Ahmed777-prog/Universal-Sensor2Freq-Optical-Sorting/Hardware Implementation/1.jpeg

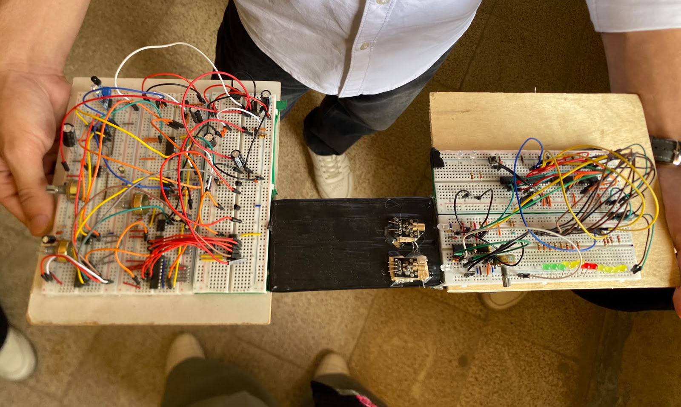
Hardware Implementation/1.jpeg
