Ahmed777-prog/Universal-Sensor2Freq-Optical-Sorting/Documentation/ProjectDocumentation.pdf

# مستند توثيق المشروع )Documentation Project)

اسم المشروع:
Universal Data Acquisition & Optical Sorting Platform )A Frequency-Based Approach for Automated Material Classification( الفريق الهندسي: سعيد حسن، أحمد أكرم، آالء سيد، جنة الجهة األكاديمية: جامعة بنها - كلية الهندسة، قسم هندسة الحاسبات ونظم التحكم

## .1 الملخص التنفيذي )Summary Executive)

يقدم هذا المشروع تصميمًا Platform Automation Customizable). ال | ًا مبتكرًا لمنصة أتمتة شاملة وقابلة للتخصيص )
يقتصر دور النظام على فرز المواد لونيًا Acquisition Data )تعتمد على تحويل | ًا، بل يمتد ليكون منصة عامة الستحواذ البيانات )
المتغيرات الفيزيائية )سواء كانت ضوء، حرارة، أو ضغط( إلى ترددات قابلة للقياس عبر تقنية )Frequency-to-Resistance Conversion). يتم استخالص "بصمة رقمية" )Footprint Digital )دقيقة لهذه الترددات، ومن ثم نقلها السلكي ًا عبر بروتوكول اتصال ضوئي متزامن ومصمم خصيصًا على مستوى العتاد، ليتم استقبالها وفك تشفيرها التخاذ قرار الفرز اآللي. إلثبات نجاح هذه
(، تم تطبيق النظام عملي ًا لفرز المواد بناًء | المعمارية )Concept of Proof على االنعكاس الضوئي.

## .2 بروتوكول االتصال الضوئي المخصص )Optical Custom )Communication Protocol

لضمان نقل البيانات بسرعة وموثوقية عالية في بيئة خالية من المتحكمات الدقيقة )Free-Microcontroller)، تم بناء بروتوكول اتصال صلب )Protocol Level-Hardware )يتميز باآلتي: •نوع االتصال: Simplex متزامن )Synchronous)، ينقل البيانات في اتجاه واحد من مرسل )TX )إلى مستقبل )RX). •القنوات الضوئية المزدوجة )Laser Channel-Dual): يعتمد البروتوكول على وحدتي ليزر منفصلتين؛ قناة مخصصة لنقل البيانات المحملة )LASER_DATA )وقناة مخصصة لنبضات التزامن )LASER_CLK)، مما يضمن دقة النقل ويلغي تعقيدات استرجاع التزامن )Recovery Clock). •تزامن العتاد )Handshaking Hardware): •إدارة اإلرسال )Switch-Kill TX): يتم تجميد النظام تمامًا فور االنتهاء من إرسال اإلطار )-8bit )باستخدام
مفتاح أمان ديجيتال، لمنع تدفق أي بيانات عشوائية.
•حماية االستقبال )Watchdog RX): يعمل المستقبل بنظام التلقيم الذاتي ليتمكن من اكتشاف نهاية اإلطار
بتات، ويقوم بتجهيز نفسه أوتوماتيكي ًا | المكون من 8 الستقبال اإلطار التالي دون فقدان التزامن.

## .3 المعمارية التقنية والتفصيلية للنظام )Architecture System Detailed)

يتكون النظام من خمس وحدات وظيفية متكاملة تعمل في تزامن تام:

الوحدة األولى: التحكم المركزي واكتشاف األحداث )Detection Event & Control Master) •االستشعار المبدئي: يتم استخدام مستشعر أشعة تحت الحمراء )Sensor IR )الكتشاف دخول المادة إلى نطاق القياس.

•توليد نبضة التزامن )Detection Edge): لضمان دقة بدء النظام، تم تصميم دائرة تفاضلية )Differentiator RC) مع ترانزستور )A2222PN )لتوليد نبضة سالبة سريعة جدًا )Spike Negative). تعمل هذه النبضة كـ )Master Reset )لتهيئة النظام وتصفير كافة العدادات في لحظة الصفر.

الوحدة الثانية: المعالجة الشاملة وتوليد التردد )Frequency-to-Sensor Universal) وهي الوحدة التي تمنح النظام صفة الـ "Universal": •المتذبذب )Astable/VCO): باستخدام مؤقت )555NE)، يتم تحويل قيمة المقاومة المتغيرة للمستشعر )LDR للون، أو Thermistor للحرارة، أو FSR للضغط( إلى تردد مستمر يمثل الخاصية الفيزيائية. •بوابة الزمن الدقيقة )Window Time): باستخدام مؤقت )555NE )آخر في وضع )Monostable)، يتم توليد نافذة
زمنية دقيقة جدًا 100 مللي ثانية( فور تلقي إشارة البدء. هذه النافذة تحدد اإلطار المسموح فيه بأخذ العينات الترددية. | ًا )مث ًال

الوحدة الثالثة: التكميم الرقمي )Quantization Digital) •تقاطع اإلشارات: يتم دمج التردد المتولد مع النافذة الزمنية عبر بوابة )08HC74 - AND)، إلنتاج حزمة محددة من النبضات المتزامنة )CLK_BURST). •استخالص البصمة )Footprint Digital): تمر النبضات إلى عدادات متتالية )- Counters Cascade 161HC74). بنهاية النافذة الزمنية، تحتفظ العدادات برقم ثنائي )-8bit )يمثل الهوية الرقمية الدقيقة للمادة.

الوحدة الرابعة: نظام اإلرسال الضوئي )System TX Optical) •تثبيت البيانات )Latching Data): لتفادي مشكلة التذبذب قبل اإلرسال، تم ابتكار دائرة خطف )Spiker RC )تولد نبضة لحظية لتفعيل طرف التحميل غير المتزامن )~PL )في مسجل اإلزاحة )165HC74)، مما يثبت البيانات قبل وصول النبضة األولى للساعة. •تفعيل اإلرسال: يقوم ُمنطاط )74HC74 - Flop-Flip-D )بتوليد إشارة التفعيل لفتح مسار ساعة اإلرسال، ويغلقه فورًا عند إتمام البت الثامن.
•القيادة )Driving Laser): يتم تضخيم اإلشارات الناتجة باستخدام ترانزستورات لقيادة ثنائيات الليزر بأعلى كفاءة.

الوحدة الخامسة: نظام االستقبال والتصنيف )Classification & RX Optical) •الواجهة التناظرية )End-Front Analog): تستقبل الثنائيات الضوئية )Photodiodes )إشارات الليزر وتمررها عبر مكبرات عمليات )Amps-Op 358LM )لتنقيتها وتحويلها إلى نبضات رقمية حادة )DATA_RX و CLK_RX). •تجميع البيانات )Parallel to Serial): يستقبل مسجل اإلزاحة )595HC74 )البيانات المتسلسلة إلعادة تجميعها، وال يتم تفعيل الخرج إال بعد اكتمال اإلطار لضمان استقرار العرض. •تزامن االستقبال )Restoring Sync): يعتمد النظام على عداد )161HC74 )مبرمج بخاصية التحميل المتزامن )~PE )ليقوم بضبط نفسه لـ 1 تلقائي ًا بمجرد استالم النبضة الثامنة، مما يحمي النظام كلي ًا من فقدان التزامن .)Desynchronization(
•التصنيف النهائي )Decoding): يتم أخذ البتات ذات األهمية القصوى )MSBs )وتمريرها لمفكك شفرة )138HC74 Decoder )لتفعيل مؤشر ضوئي )LED )يعبر عن فئة المادة.

## .4 التحديات الهندسية والحلول )& Challenges Engineering )Robustness

تم إجراء هندسة وقائية للنظام لضمان استقراره في البيئات العملية: .1مشكلة تذبذب البيانات )Output Dancing): تم حلها جذري ًا عبر تصميم دائرة )Generator Pulse )تناظرية باستخدام مكثف لتفعيل إشارة الـ Load لكسر من الميكروثانية وتجميد حالة البيانات. .2مشكلة فقدان التزامن في االستقبال )Desync RX): تم حلها باالستغناء عن البوابات المنطقية المعقدة لصالح استغالل خاصية التلقيم الذاتي المتزامن )Reload-Auto )داخل عدادات الـ RX. .3الضوضاء والتيار اللحظي )Current Inrush): تمت إضافة مكثفات تنعيم )Capacitors Decoupling )مباشرة على الدوائر المتكاملة الحساسة المتصاص التغيرات اللحظية في الجهد الناتجة عن تبديل الـ 8 بتات في نفس اللحظة .)Ground Bounce(
