Ahmed777-prog/Universal-Sensor2Freq-Optical-Sorting/Schematics/Frequency-to-Digital Coverter via Li-Fi Latest Schematic.pdf

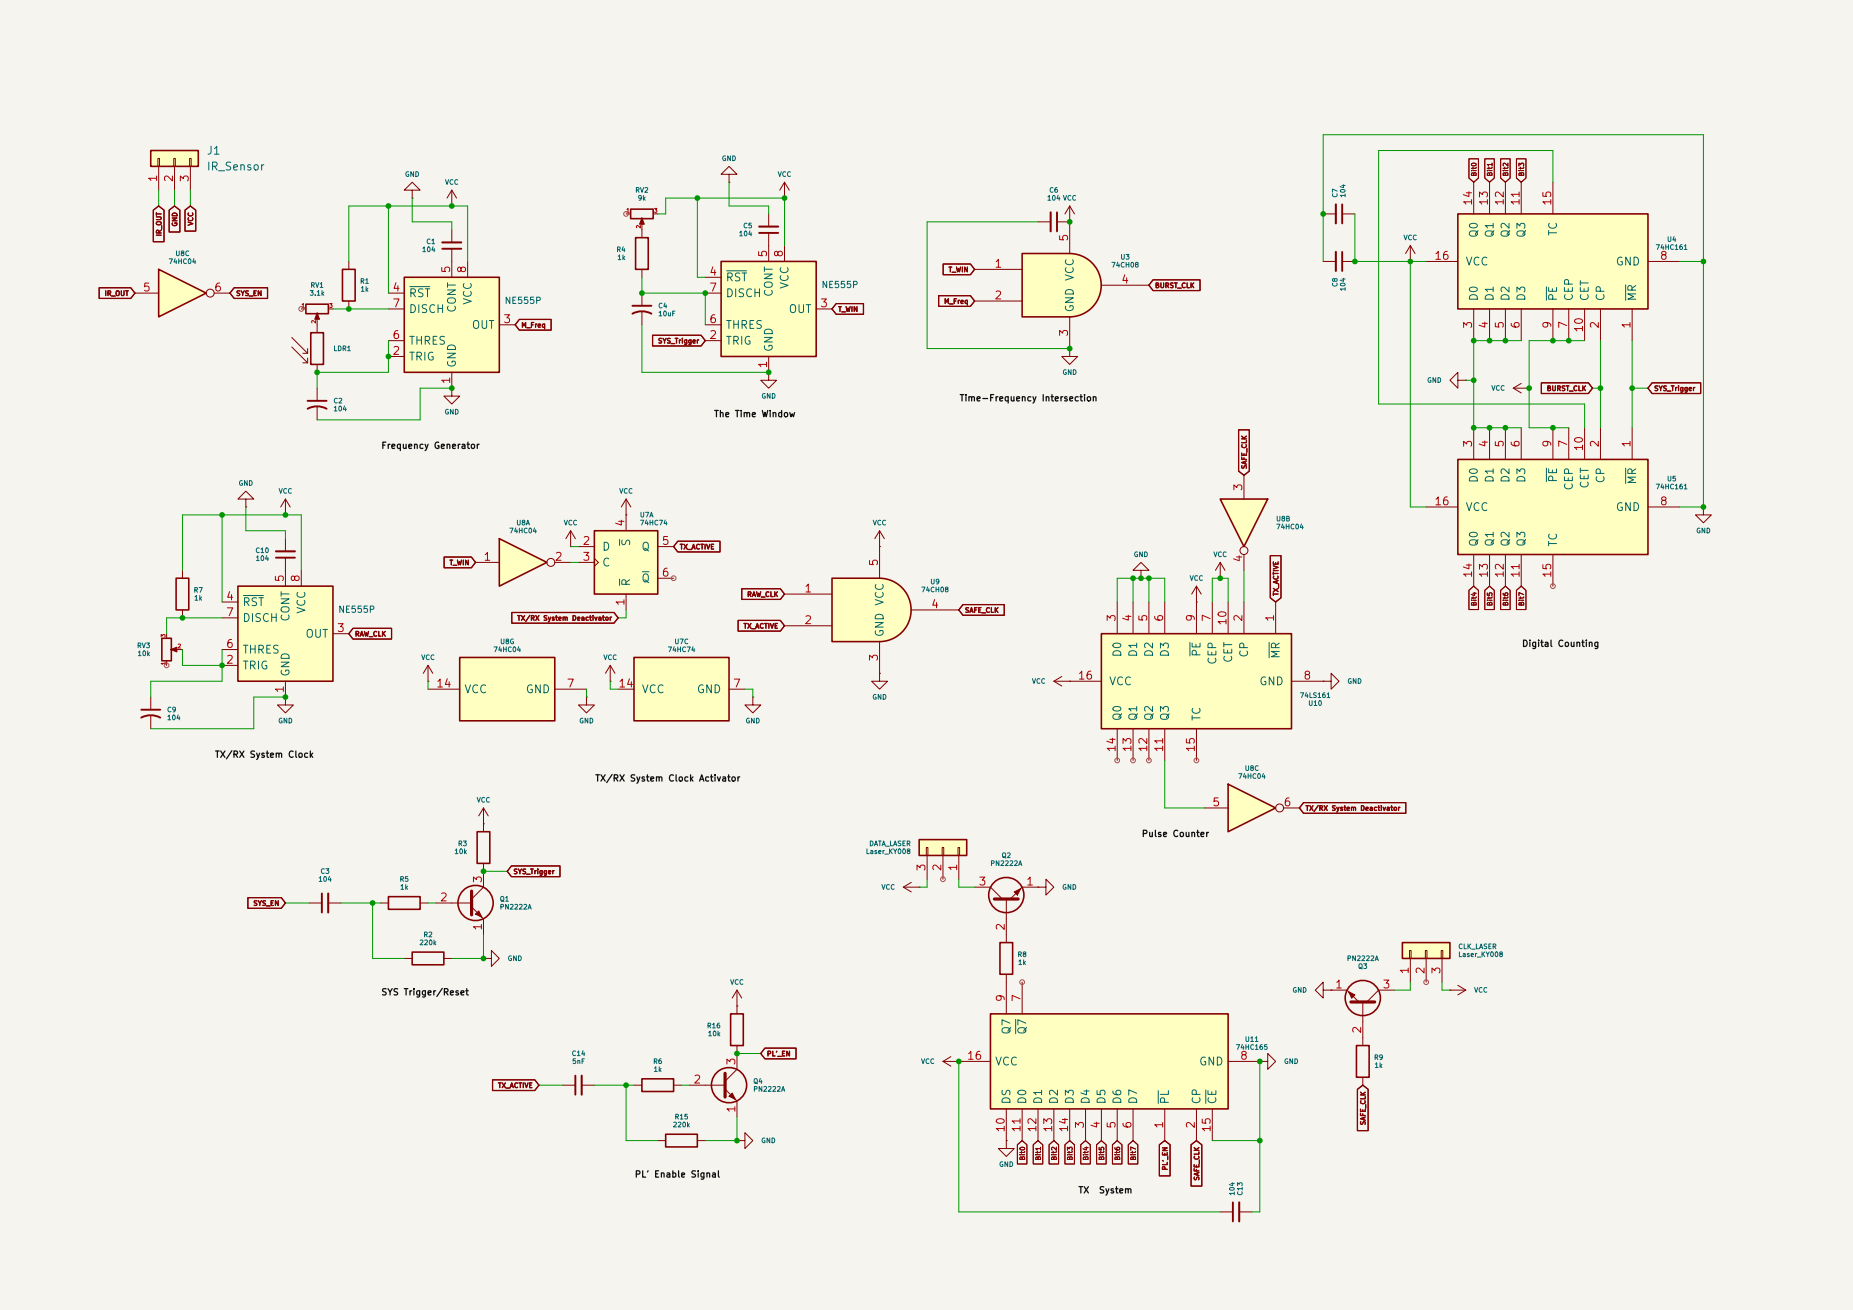
[picture p2: page 1]

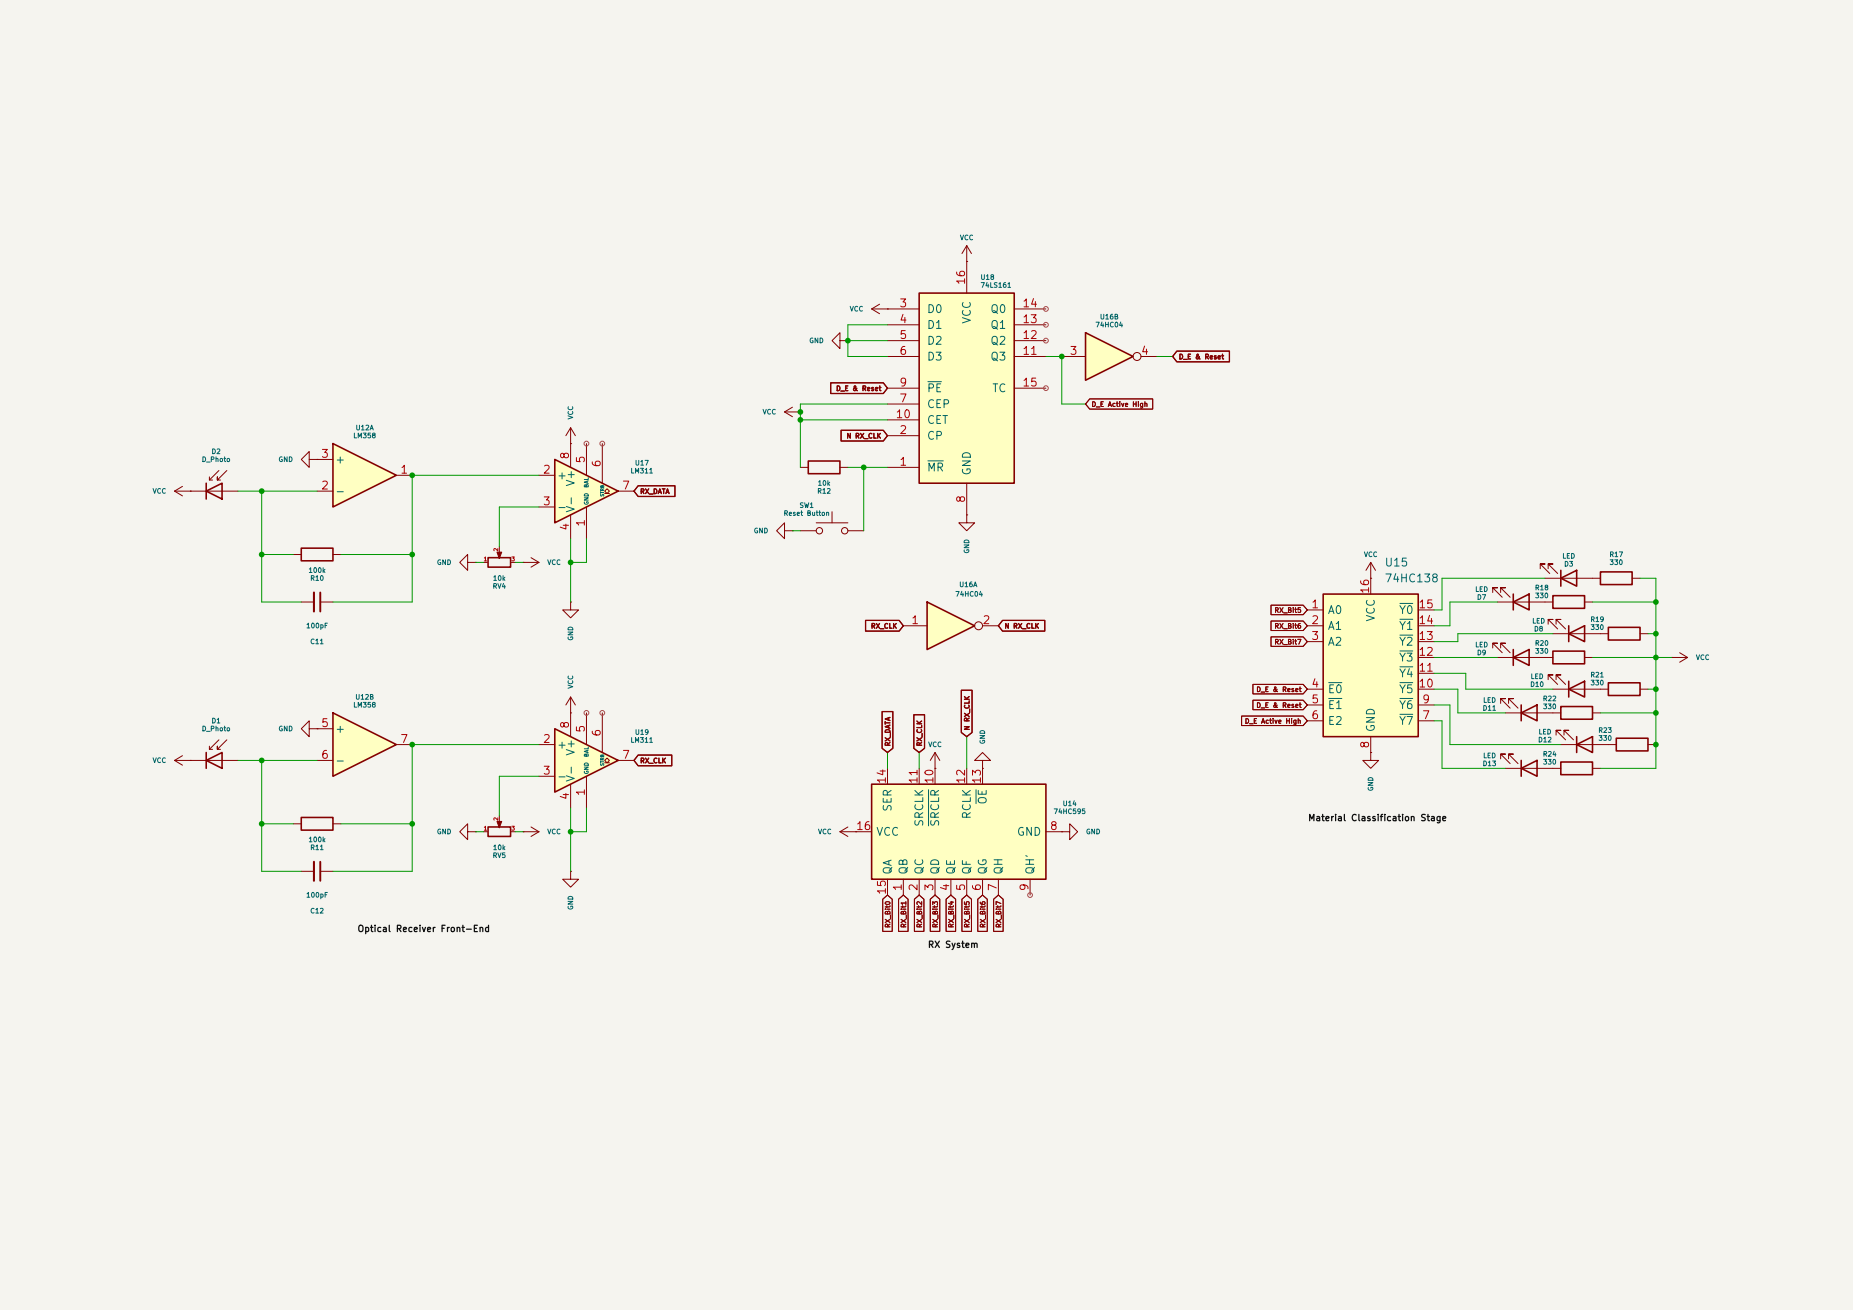
[picture p3: page 2]
