Ahmed777-prog/Universal-Sensor2Freq-Optical-Sorting/(list of files, drawings)

Other design files:
Simulation/simulation.pdsprj
